kikeelectronico/pepperoni/README.md

# Pepperoni

Pepperoni es un robot de combate de 1 libra diseñado para competir en OSHWdem 2023

Documentación en: https://pepperoni.enriquegomez.me
