kikeelectronico/pepperoni/docs-web/content/galeria.md

---
title: "Galería"
---

## Primeros pasos

Primera vez que Pepperoni se desplaza sobre sus ruedas.

{{< yt "WIlDZOEus2Y" "Primeros pasos de Pepperoni" >}}

## Test de spinner

Primer test de giro del spinner de Pepperoni llegando a una velocidad del 40% de la velocidad máxima.

{{< yt "U2f0mU5--3Y" "Test de spinner de Pepperoni" >}}
