kikeelectronico/pepperoni/docs-web/docs/bloqueos/bloqueos.md

---
sidebar_position: 2
---

# Bloqueos de arma

Pepperoni cuenta con un arma cinética que de ser encendida por error puede causar daños personales y materiales. Por favor, ten mucho cuidado al manipular el robot y bloquea el arma, especialmente cuando la batería está conectada.

El robot cuenta con dos sistemas de bloqueo de arma que se alinean con uno de los agujeros del arma para atravesarla.

## Bloqueo por tornillo

Se puede introducir un tornillo M3x25 en el inserto roscado desde la parte inferior del robot.

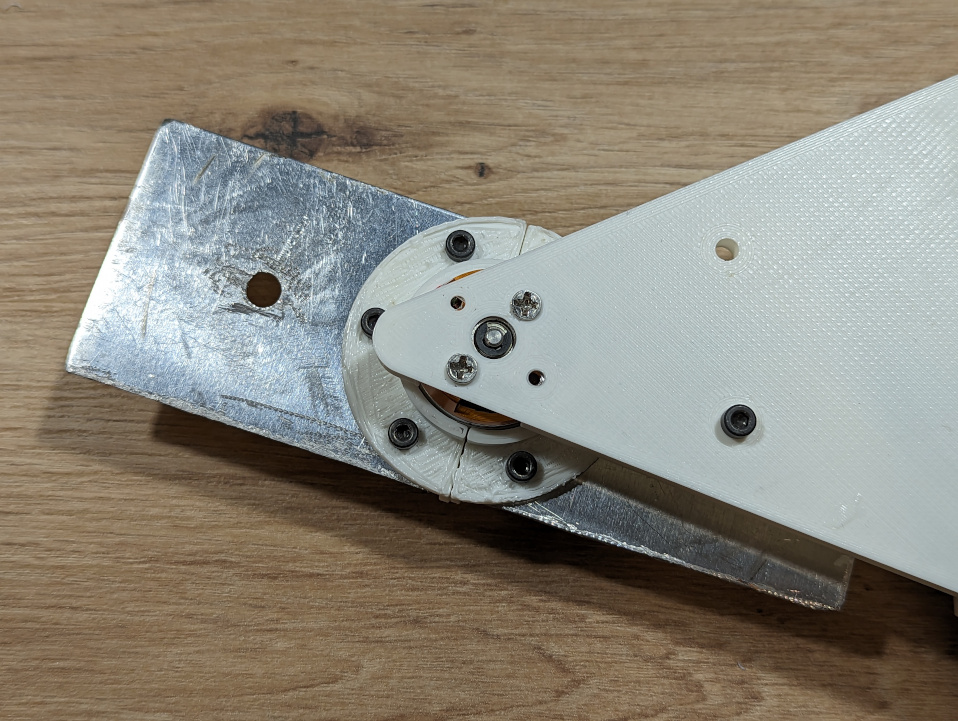
[picture p1: docs-web/docs/bloqueos/assets/tornillo_de_bloqueo.jpg]
Tornillo de bloqueo


Desde la parte superior se ve de la siguiente manera:

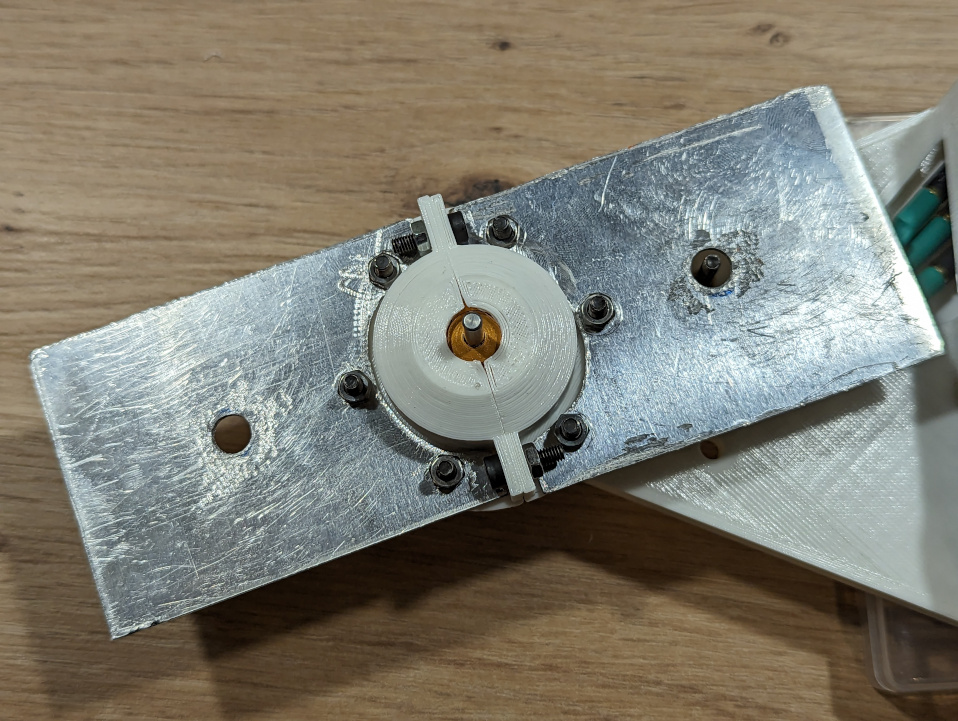
[picture p2: docs-web/docs/bloqueos/assets/arma_bloqueada_por_tornillo.jpg]
Arma bloqueada por tornillo


## Bloque por barra

Se puede introducir un objeto con forma de barra como un destornillador por el agujero de la tapa que no cuenta con inserto.

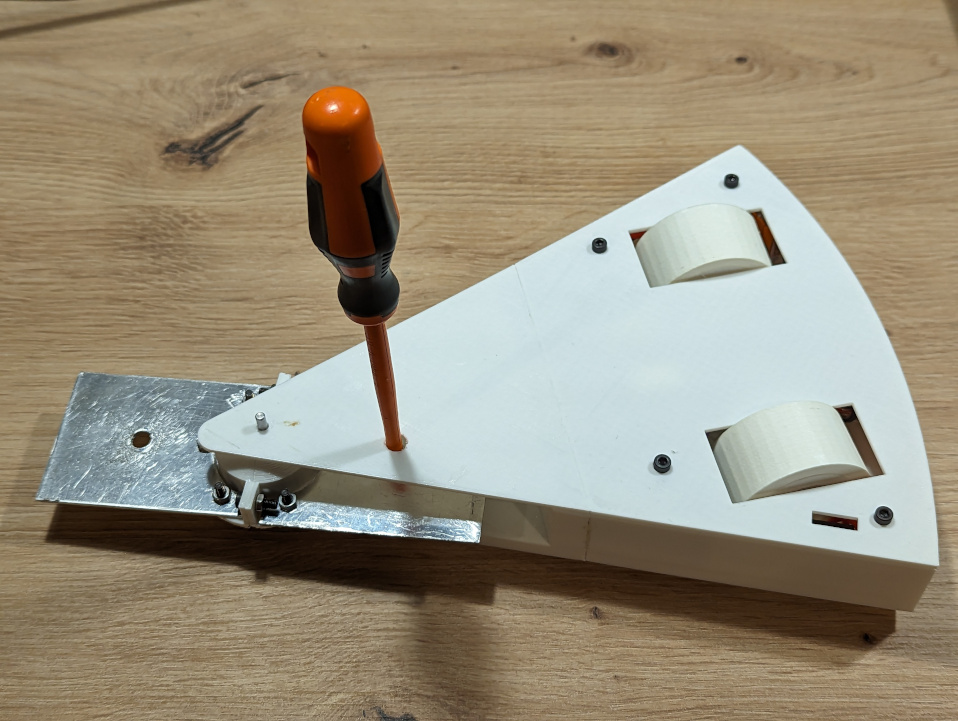
[picture p3: docs-web/docs/bloqueos/assets/arma_bloqueada_por_barra.jpg]
Arma bloqueada por una barra
