kikeelectronico/pepperoni/docs-web/content/docs/_index.md

---
title: "Documentación"
description: "Guía de construcción, configuración y uso de Pepperoni."
---

Todo lo necesario para construir, configurar y controlar a Pepperoni.
