kikeelectronico/pepperoni/docs-web/docs/bom.md

---
sidebar_position: 3
---

# BOM

| Componente | Cantidad | Enlaces de compra* |
| - | - | - |
| Motor N20 6 V 200 RPM | 2 | [Amazon](https://www.amazon.es/dp/B01N6LJN43) |
| ESC motor DC con freno | 2 | [Amazon](https://www.amazon.es/dp/B07R8PV71M) |
| Batería LiPo 2S 450 mAh | 1 | [Amazon](https://www.amazon.es/dp/B07LFJXMNP) |
| Motor brushless | 1 | [Amazon](https://www.amazon.es/dp/B01IVKZNQQ) |
| ESC motor burshless | 1 | [Amazon](https://www.amazon.es/dp/B0BGC1QQ6T) |
| Conector XT60 macho | 1 | [Amazon](https://www.amazon.es/dp/B0BM9J42HM) |
| Conector XT60 hembra | 2 | [Amazon](https://www.amazon.es/dp/B0BM9J42HM) |
| Conectores Wago | 2 | [Amazon](https://www.amazon.es/unidades-221-415-terminal-conexi%C3%B3n-transparente/dp/B07NKDCJPL) |
| Interruptor 15 A basculante | 1 | [Amazon](https://www.amazon.es/Interruptor-universal-off-Negro-Cablepelado%C2%AE/dp/B07CMG69BK) |
| Receptor RF 6 canales** | 1 | [Amazon](https://www.amazon.es/Dilwe-Receptor-Accesorio-Control-Frecuencia/dp/B07PBRSHHH/) |
| Tornillos M3x16 acero | 18 | [RationalStock](https://www.rationalstock.es/catalogo/producto/fijacion/tornillos/tornillos-cilindricos-rosca-metrica/tornillo-din-912-de-cabeza-cilindrica-con-hueco-hexagonal--de-a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) |
| Tornillos M3x25 acero | 1 | [RationalStock](https://www.rationalstock.es/catalogo/producto/fijacion/tornillos/tornillos-cilindricos-rosca-metrica/tornillo-din-912-de-cabeza-cilindrica-con-hueco-hexagonal--de-a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) |
| Insertos para plástico M3 | 10 | [Amazon](https://www.amazon.es/M2-M2-5-M3-M4-M5/dp/B0BZVL5864) |
| Tuerca M3 acero | 8 | [RationalStock](https://www.rationalstock.es/catalogo/producto/fijacion/tuercas/tuercas-hexagonales/tuerca-din-934-hexagonal--de-acero-inoxidable-a2-y-rosca-metrica-/20450500005) |
| Cableado 1 mm² | N/A | [Amazon](https://www.amazon.es/dp/B09VGQKXS1) |
| PLA | 1 kg | [Smart materials](https://www.smartmaterials3d.com/pla-filamento#/3-tamano-l_1000g/26-diametro-175_mm/103-color-snow) |
| TPU | 330 g | [Smart materials](https://www.smartmaterials3d.com/flex-filamento#/1-tamano-s_330g/8-color-ivory_white/26-diametro-175_mm) |

*Los enlaces de compra son de ejemplo. Pueden no representar con exactitud el producto.

**El receptor depende de la emisora que vayas a usar. Elige uno compatible. Yo he usado la emisora Flysky FS-i6.
