kikeelectronico/pepperoni/3d-model/3mf/stand.3mf

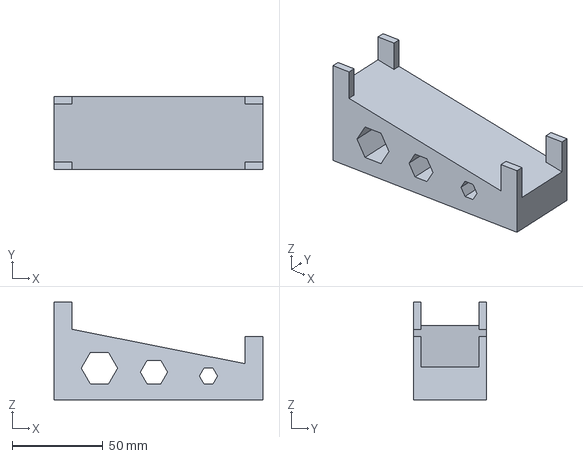
[picture p11: CAD file, 2023-11-06]
3d-model/3mf/stand.3mf
115.0 x 40.0 x 53.9 mm
