kikeelectronico/pepperoni/3d-model/3mf/plantilla pepperoni.3mf

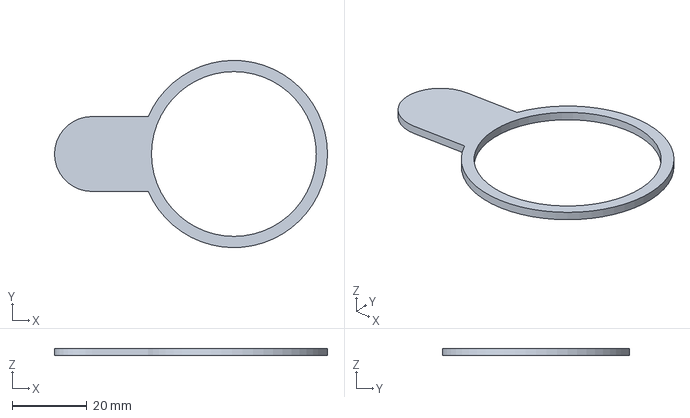
[picture p12: CAD file, 2023-10-12]
3d-model/3mf/plantilla pepperoni.3mf
72.9 x 50.0 x 2.00 mm
