kikeelectronico/pepperoni/3d-model/3mf/grapa arma.3mf

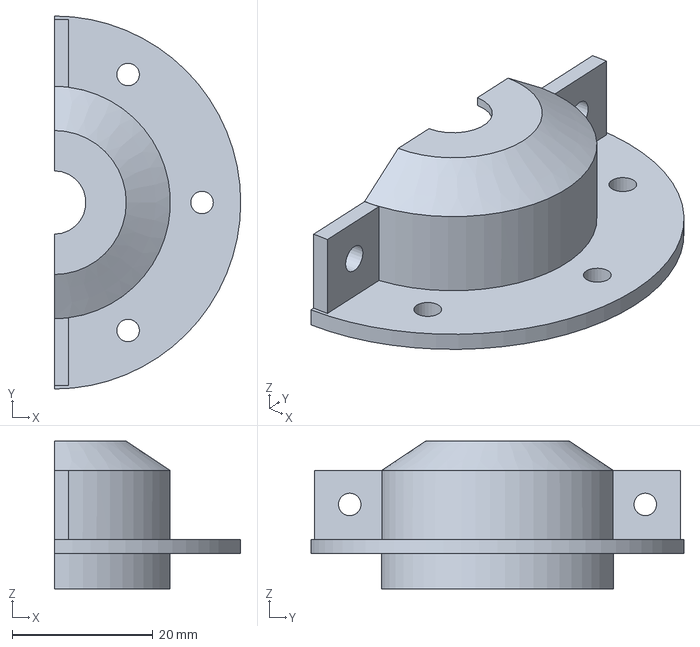
[picture p13: CAD file, 2023-10-03]
3d-model/3mf/grapa arma.3mf
26.5 x 53.0 x 21.0 mm
