kikeelectronico/pepperoni/3d-model/design/hoja arma.FCStd

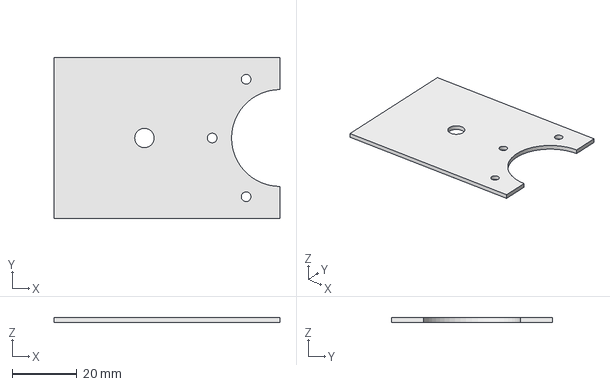
[picture p14: CAD file, 2023-10-12]
3d-model/design/hoja arma.FCStd
70.0 x 50.0 x 1.50 mm
