kikeelectronico/pepperoni/3d-model/3mf/pinza ESC.3mf

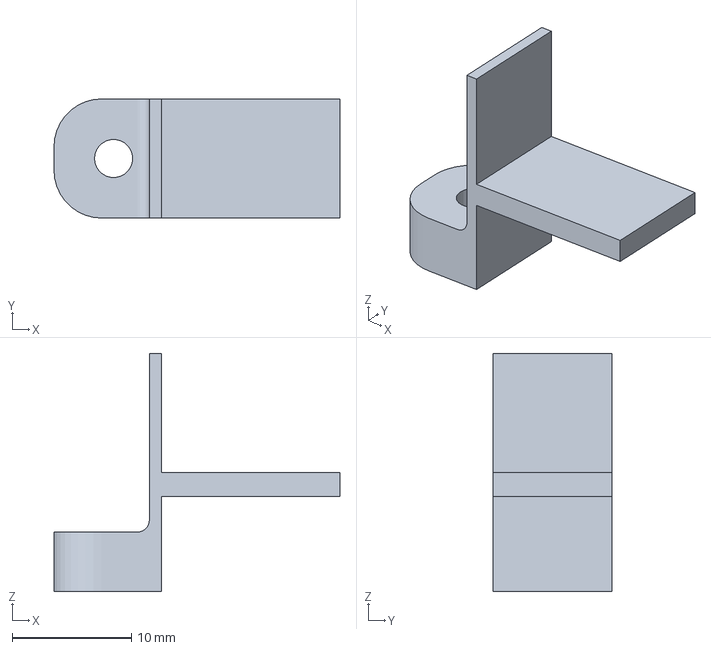
[picture p15: CAD file, 2023-10-03]
3d-model/3mf/pinza ESC.3mf
24.0 x 10.0 x 20.0 mm
