kikeelectronico/pepperoni/3d-model/design/grapa arma.FCStd

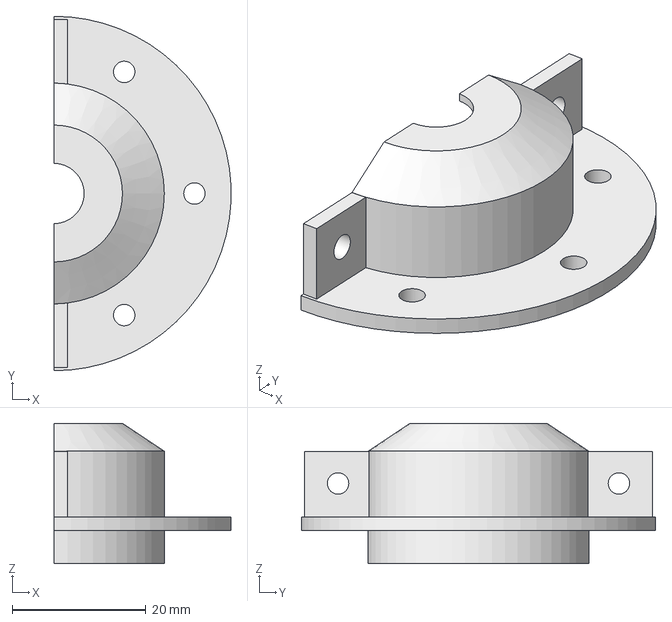
[picture p16: CAD file, 2023-10-10]
3d-model/design/grapa arma.FCStd
26.5 x 53.0 x 21.0 mm
