kikeelectronico/pepperoni/3d-model/3mf/pinza batería.3mf

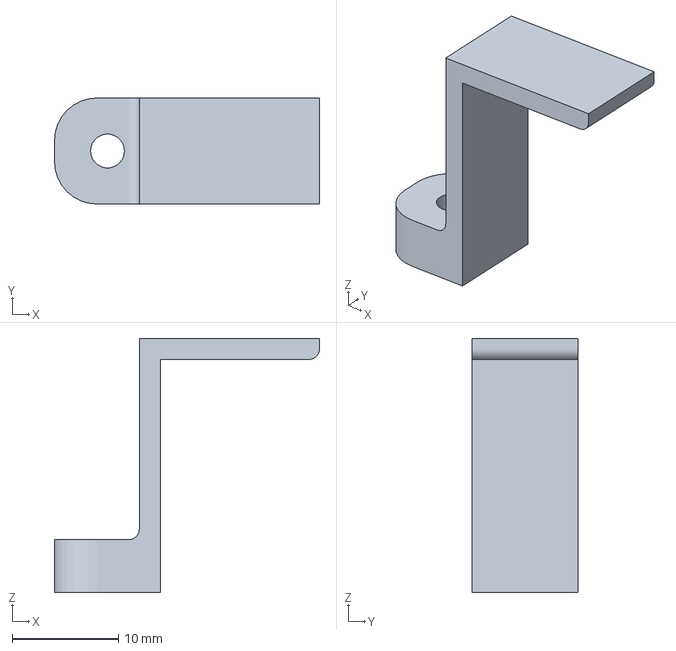
[picture p17: CAD file, 2023-10-01]
3d-model/3mf/pinza batería.3mf
25.0 x 10.0 x 24.0 mm
