kikeelectronico/pepperoni/3d-model/3mf/tapa.3mf

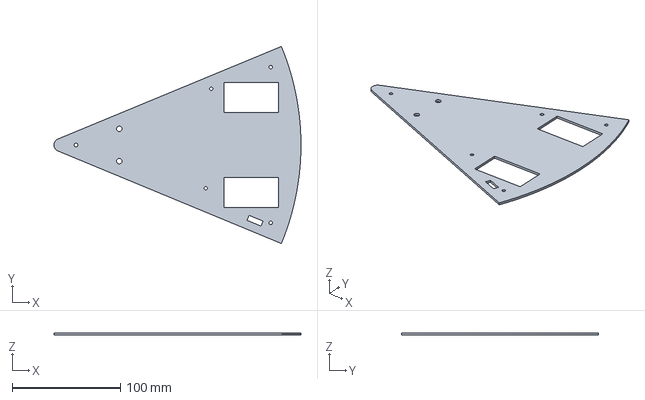
[picture p18: CAD file, 2023-10-01]
3d-model/3mf/tapa.3mf
228.3 x 182.2 x 2.00 mm
