kikeelectronico/pepperoni/3d-model/3mf/grapa motor.3mf

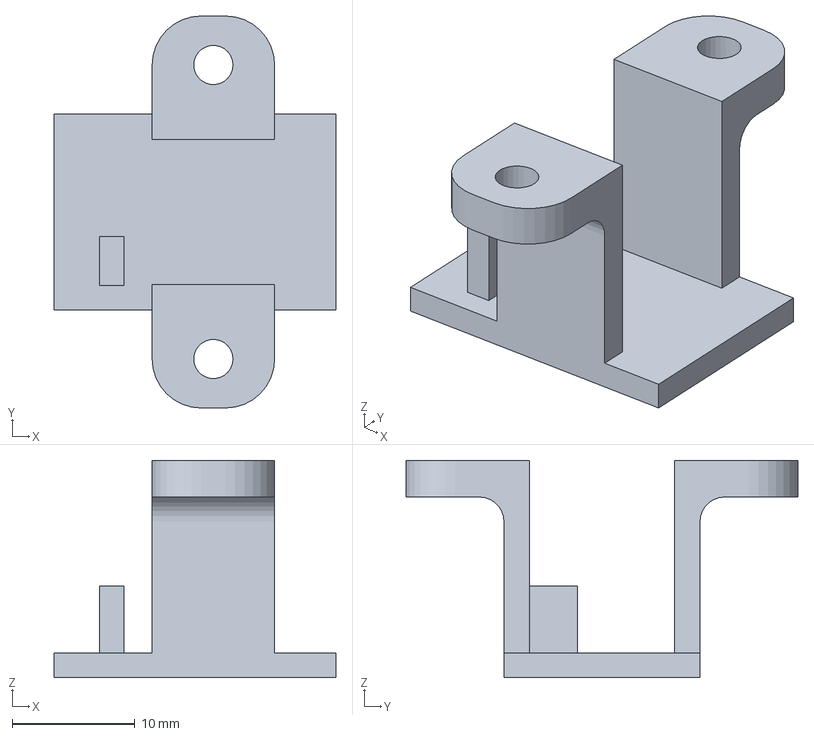
[picture p19: CAD file, 2023-09-29]
3d-model/3mf/grapa motor.3mf
23.0 x 32.0 x 17.8 mm
