kikeelectronico/pepperoni/3d-model/design/neumatico 2.FCStd

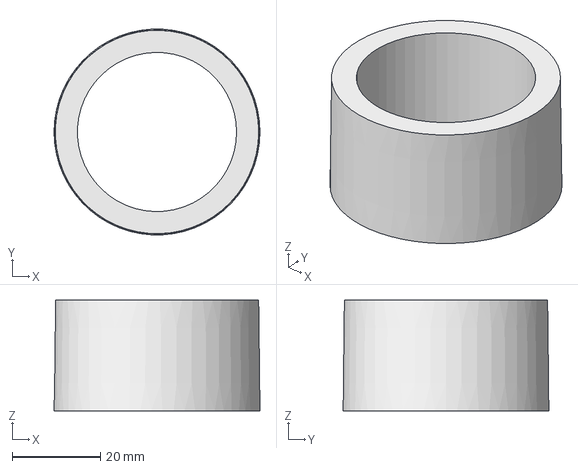
[picture p20: CAD file, 2023-09-29]
3d-model/design/neumatico 2.FCStd
46.6 x 46.5 x 25.0 mm
