kikeelectronico/pepperoni/3d-model/3mf/base.3mf

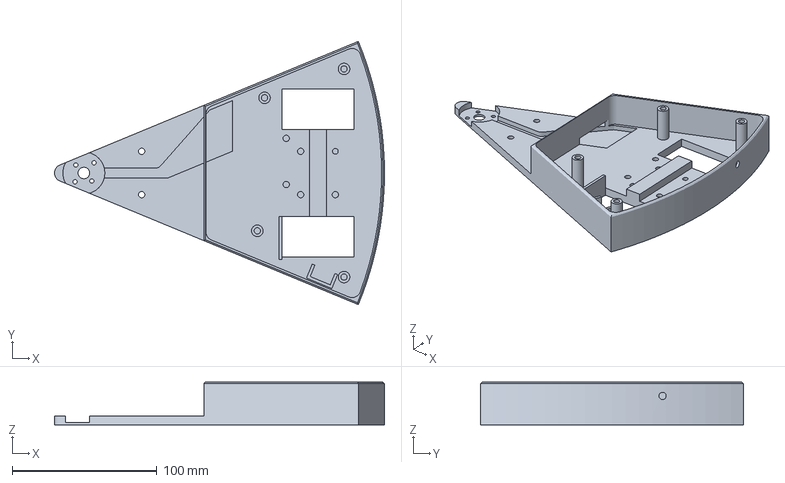
[picture p21: CAD file, 2023-09-29]
3d-model/3mf/base.3mf
228.3 x 182.2 x 29.5 mm
