kikeelectronico/pepperoni/3d-model/design/neumático.FCStd

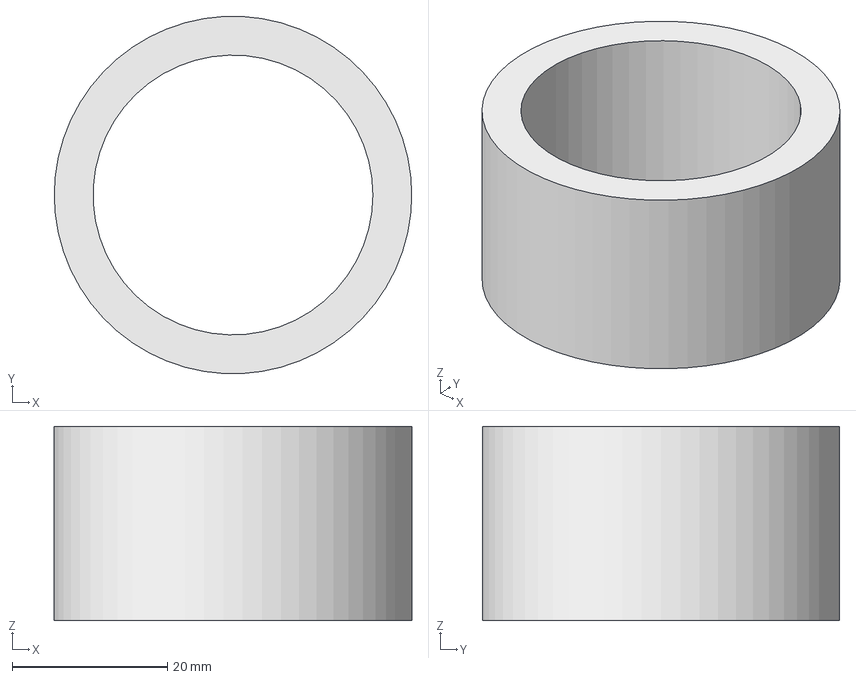
[picture p22: CAD file, 2023-09-29]
3d-model/design/neumático.FCStd
46.0 x 45.9 x 25.0 mm
