kikeelectronico/pepperoni/3d-model/3mf/llanta.3mf

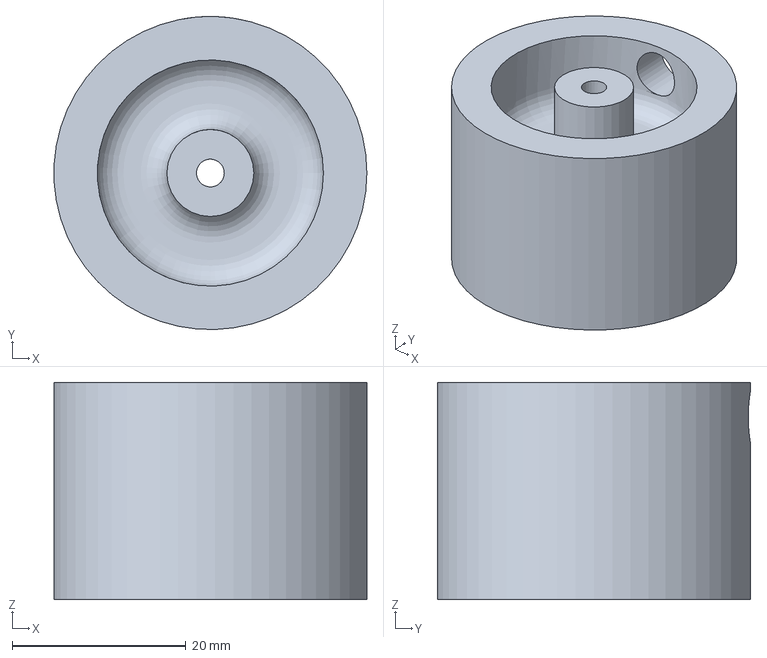
[picture p23: CAD file, 2023-09-21]
3d-model/3mf/llanta.3mf
36.0 x 36.0 x 25.0 mm
