kikeelectronico/pepperoni/3d-model/3mf/soporte ESC DC.3mf

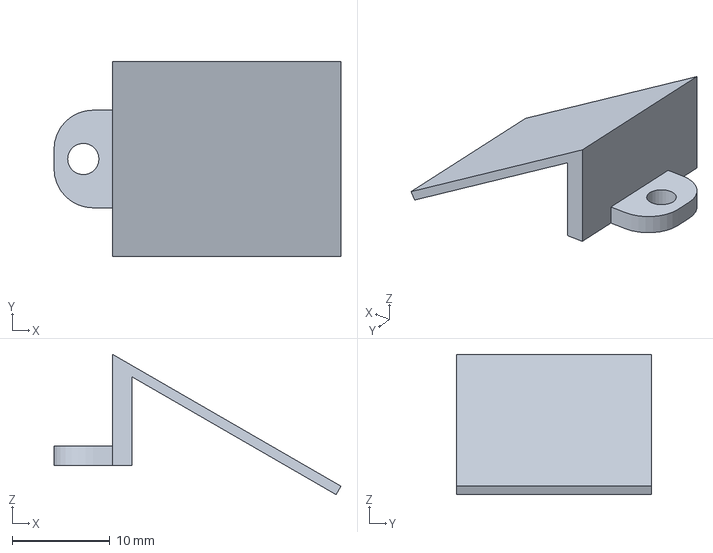
[picture p24: CAD file, 2023-09-11]
3d-model/3mf/soporte ESC DC.3mf
29.4 x 20.0 x 14.4 mm
