kikeelectronico/pepperoni/3d-model/3mf/separador 2mm.3mf

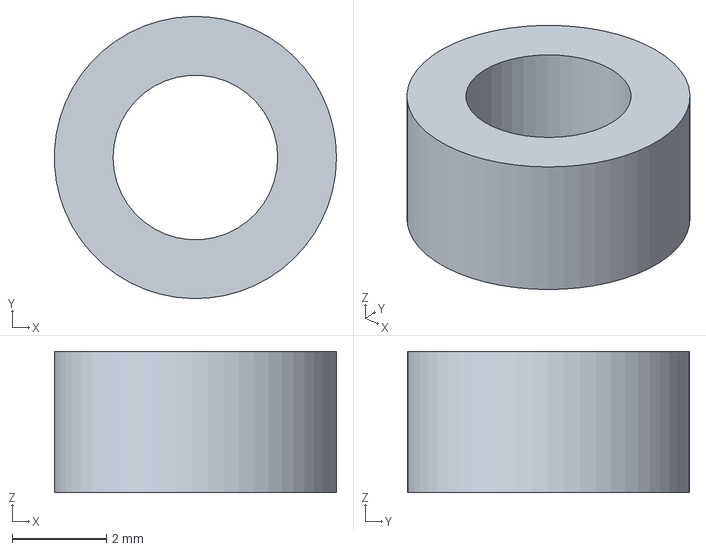
[picture p25: CAD file, 2023-09-11]
3d-model/3mf/separador 2mm.3mf
6.00 x 6.00 x 3.00 mm
