kikeelectronico/pepperoni/3d-model/design/Pepproni.FCStd

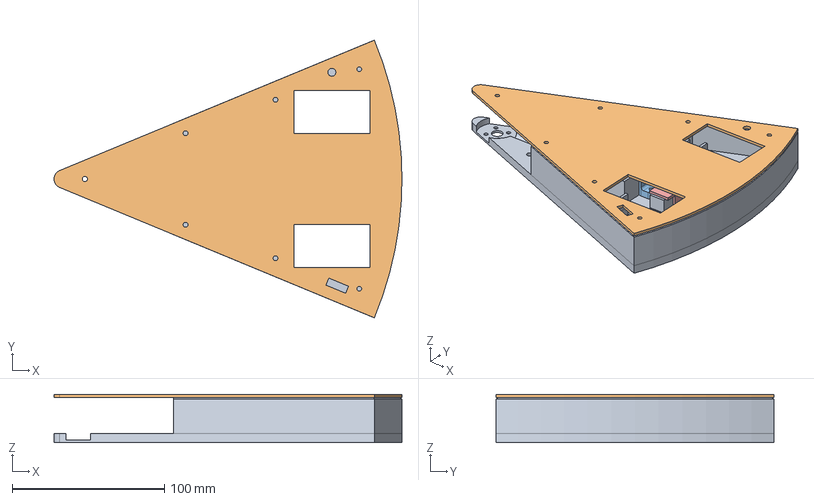
[picture p26: CAD file, 2023-09-11]
3d-model/design/Pepproni.FCStd
228.3 x 182.2 x 31.5 mm
base_001
tapa_superior_001
grapa batería_001
grapa motor_001
grapa motor_002
soporte esc dc_001
soporte esc dc_002
separador 3mm_001
separador 3mm_002
pinza ESC_001
pinza ESC_002
