kikeelectronico/pepperoni/(list of files, cad)

Other CAD files:
3d-model/design/stand.FCStd
3d-model/design/plantilla pepperoni.FCStd
3d-model/design/pinza ESC.FCStd
3d-model/design/pinza batería.FCStd
3d-model/design/grapa motor.FCStd
3d-model/3mf/neumatico 2.3mf
3d-model/3mf/neumático.3mf
3d-model/design/tapa.FCStd
3d-model/design/base.FCStd
3d-model/design/llanta.FCStd
3d-model/design/separador 2mm.FCStd
3d-model/design/soporte ESC DC.FCStd
