kikeelectronico/pepperoni/docs-web/docs/printing.md

---
sidebar_position: 4
---

# Impresión 3D

Pepperoni se conforma de múltiples piezas impresas en 3D. Todas ellas se pueden entrar en formato [3mf](https://github.com/kikeelectronico/pepperoni/tree/main/3d-model/3mf) para impresión y en el formato de diseño de [FreeCAD](https://github.com/kikeelectronico/pepperoni/tree/main/3d-model/design).

| Pieza | Material | Cantidad |
| - | - | - |
| base |  PLA | 1 |
| grapa arma |  PLA | 2 |
| grapa motor |  PLA | 2 |
| llanta |  PLA | 1 |
| neumático |  TPU | 1 |
| pinza batería |  PLA | 1 |
| pinza ESC |  PLA | 1 |
| separador 2 mm |  PLA | 2 |
| soporte ESC DC |  PLA | 2 |
| tapa |  PLA | 1 |
