kikeelectronico/pepperoni/docs-web/content/docs/ensamblaje/index.md

---
title: "Ensamblaje"
weight: 1
---

Esta guía describe el proceso de ensamblaje de Pepperoni.

## Antes de comenzar

Revisa que dispones de todos los materiales descritos en el [BOM](/docs/bom/), de todas las piezas [impresas en 3D](/docs/printing/) y de las piezas que conforman el [arma](/docs/arma/). Si usas materiales alternativos puede que necesites improvisar, pero improvisar mola.

## Paso a paso

### 1. Base del chasis

#### Materiales necesarios

- 1 x Pieza impresa _base_.
- 11 x Inserto metálico para plástico M3.

#### Proceso

Introduce los insertos en sus respectivos agujeros. Fíjate en la imagen para localizar su posición. 

Para cada inserto:

1. Coloca de forma superficial el inserto sobre el agujero.
2. Usa un soldador caliente para empujar el inserto dentro del agujero.

{{< admonition type="tip" >}}
No hagas mucha fuerza con el soldador. Los insertos se introducen muy rápidamente una vez alcanzan la temperatura óptima.
{{< /admonition >}}

Base del robot con insertos

### 2. Motor del spinner

#### Materiales necesarios

- Subensamblaje del paso anterior.
- 1 x Motor brushless.
- 4 x Tornillo M3x4.

#### Proceso

{{< tabs >}}
{{< tab label="Paso 2.1" default="true" >}}
Coloca el motor en su espacio del chasis como se muestra en la siguiente imagen. Presta atención a la alineación de los cables, estos deben guiarse por el correspondiente canal.

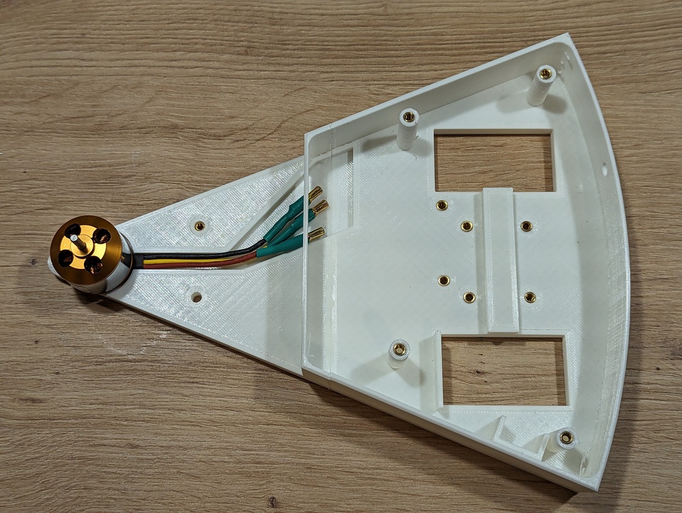
[picture p34: docs-web/docs/ensamblaje/assets/step_2_1.jpg]
Paso 2.1

{{< /tab >}}
{{< tab label="Paso 2.2" >}}
Dale la vuelta al chasis y coloca los tornillos para anclar el motor al chasis.

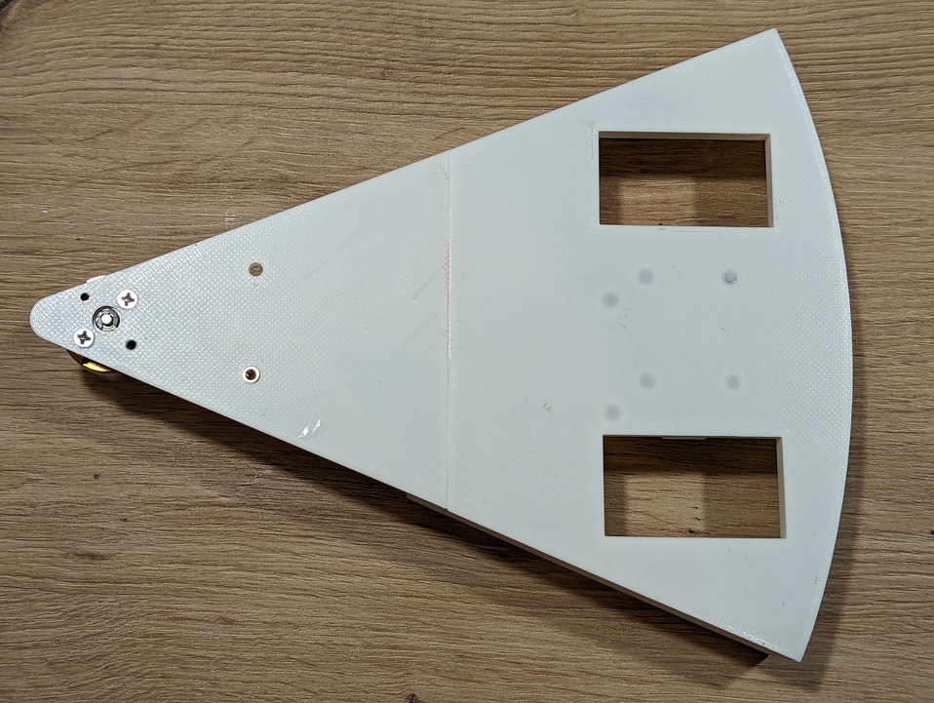
[picture p35: docs-web/docs/ensamblaje/assets/step_2_2.jpg]
Paso 2.2

{{< /tab >}}
{{< /tabs >}}

### 3. ESC del motor del spinner

#### Materiales necesarios

- Subensamblaje del paso anterior.
- 1 x Pieza impresa _pinza ESC_.
- 1 x ESC para motor brushless.
- 1 x Tornillo M3x16.

#### Proceso

{{< tabs >}}
{{< tab label="Paso 3.1" default="true" >}}
Pasa los cables del motor brushless por la apertura del chasis y conecta los tres cables del motor brushless al ESC.

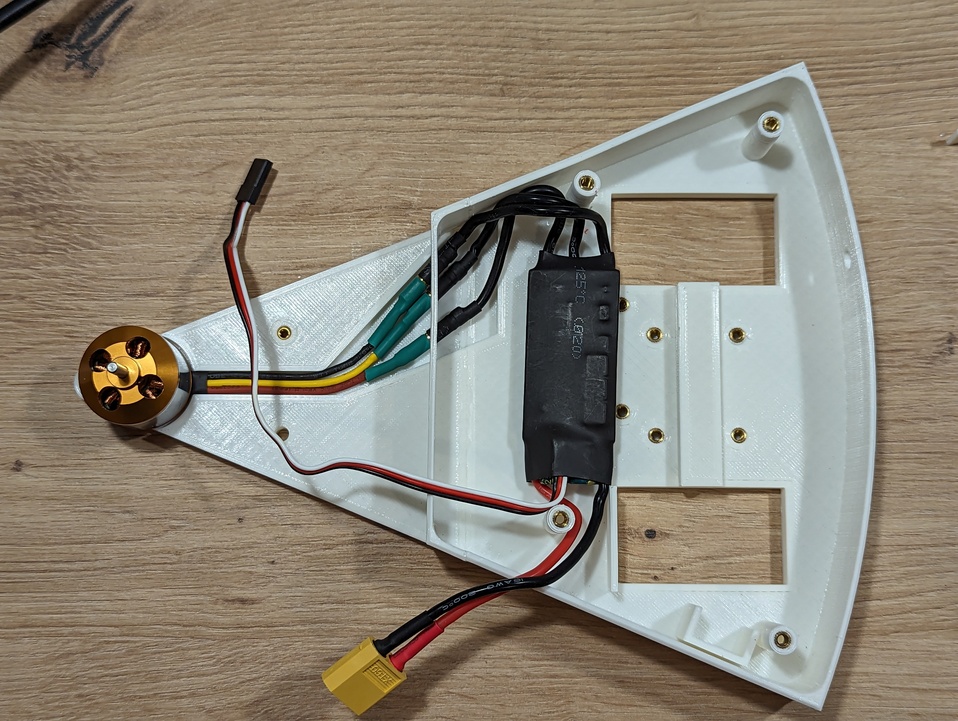
[picture p36: docs-web/docs/ensamblaje/assets/step_3_1.jpg]
Paso 3.1

{{< /tab >}}
{{< tab label="Paso 3.2" >}}
Fija el ESC al chasis usando la pieza impresa _pinza ESC_ y el tornillo M3x16.

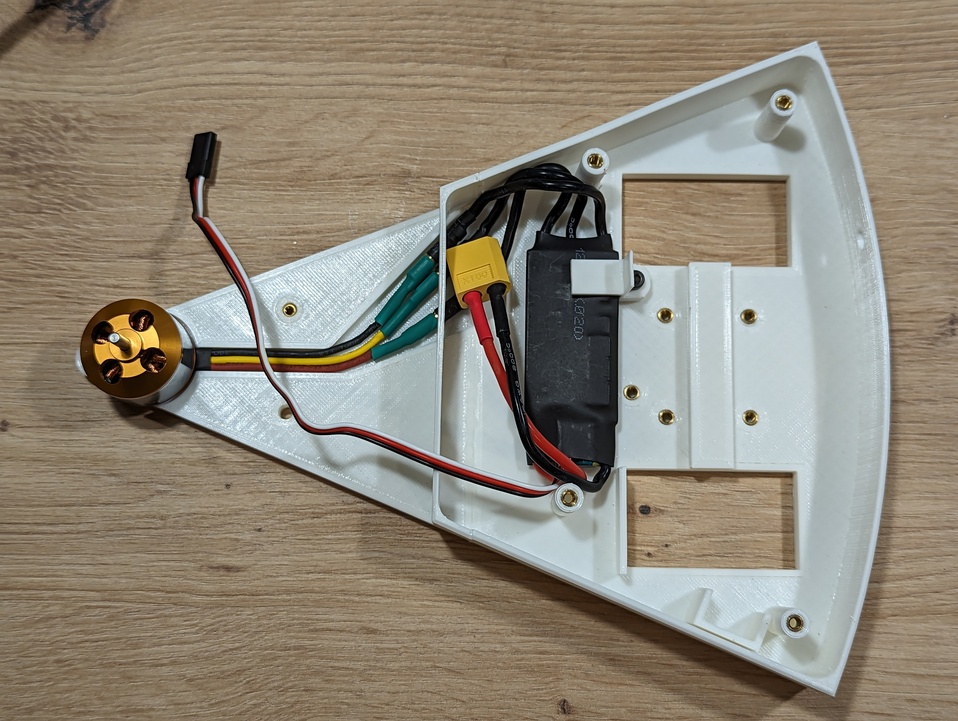
[picture p37: docs-web/docs/ensamblaje/assets/step_3_2.jpg]
Paso 3.2

{{< /tab >}}
{{< /tabs >}}

### 4. ESC y motores DC

#### Materiales necesarios

- 2 x Motor DC.
- 2 x ESC para motor DC.

#### Proceso

Para cada motor:

1. Conecta mediante cables y soldadura el motor DC con el ESC de corriente continua.
2. Quita el cable central de alimentación del conector de tres pines que irá conectado al receptor.

{{< admonition type="tip" >}}
Corta los cables con las siguientes longitudes.
- Motor DC: 50 mm.
- Conector tres pines: 60 mm.
- Cables de alimentación: 60 mm.
{{< /admonition >}}

Motor DC conectado a ESC

### 5. Ruedas

#### Materiales necesarios

- Subensamblaje del paso anterior.
- 2 x Pieza impresa _llanta_.
- 2 x Pieza impresa _neumático_.
- 2 x Inserto metálico para plástico M3.
- 2 x Tornillo M3x16.  

#### Proceso

Repite el proceso para cada rueda:

{{< tabs >}}
{{< tab label="Paso 5.1" default="true" >}}
Coloca el inserto sobre el agujero perpendicular al eje de rotación de la rueda y atornilla el tornillo girándolo muy pocas vueltas.

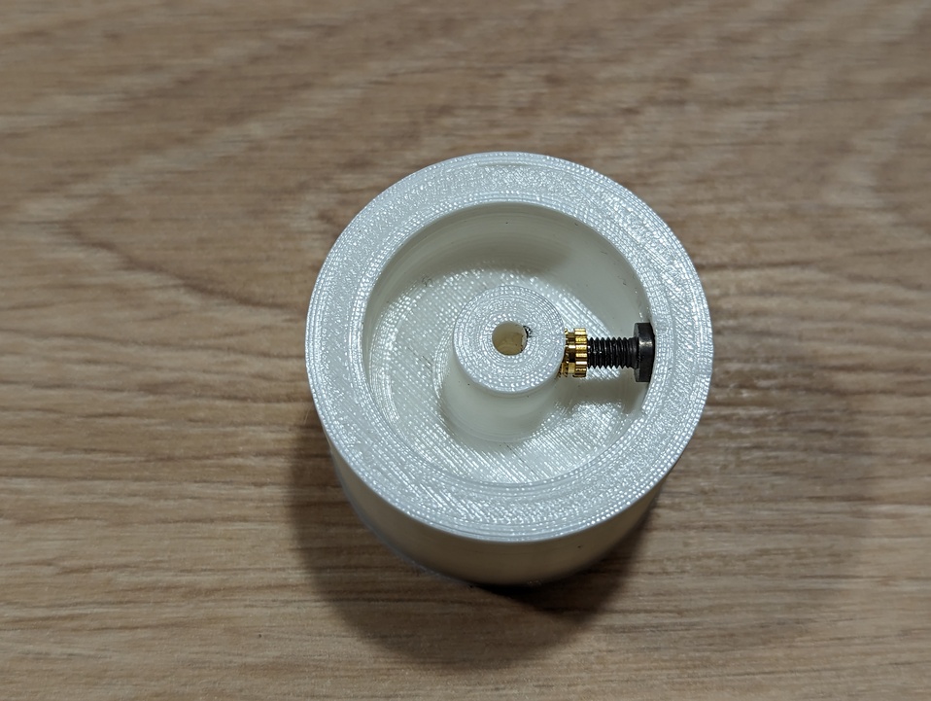
[picture p38: docs-web/content/docs/ensamblaje/assets/step_5_1.jpg]
Paso 5.1

{{< /tab >}}
{{< tab label="Paso 5.2" >}}
Introduce el eje del motor DC por el agujero central de la llanta y aprieta el tornillo hasta fijarlos. Ten en cuenta que la cara plana del eje del motor debe estar alineada con el tornillo de la llanta.

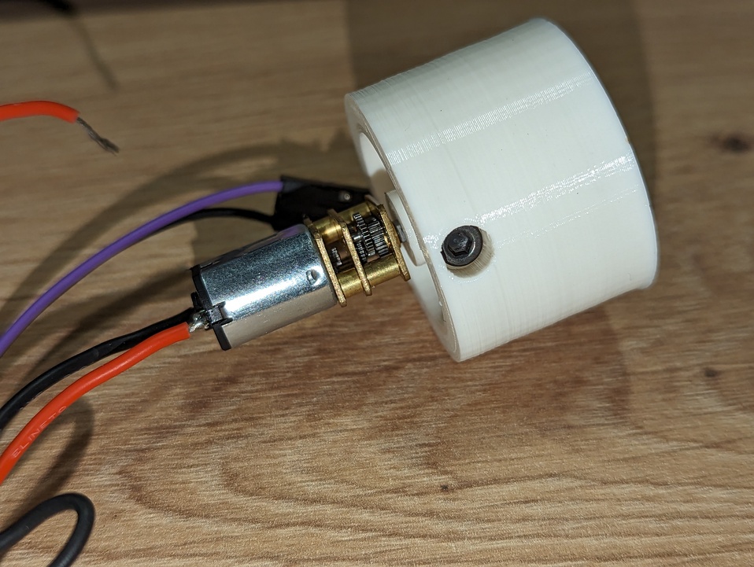
[picture p39: docs-web/content/docs/ensamblaje/assets/step_5_2.jpg]
Paso 5.2

{{< /tab >}}
{{< tab label="Paso 5.3" >}}
Coloca el neumático alrededor de la llanta.

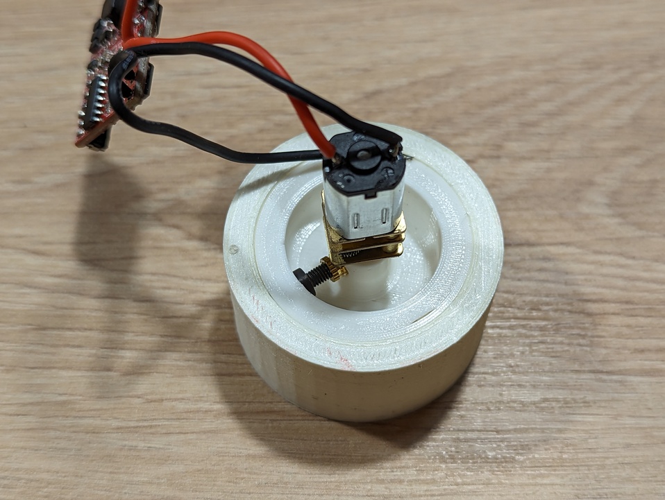
[picture p40: docs-web/docs/ensamblaje/assets/step_5_3.jpg]
Paso 5.3

{{< /tab >}}
{{< /tabs >}}

### 6. Motores en el chasis

#### Materiales necesarios

- Subensamblaje del paso 3.
- Subensamblaje del paso 5.
- 2 x Pieza impresa _grapa motor DC_.
- 2 x Pieza impresa _soporte ESC DC_.
- 2 x Pieza impresa _separador 2mm_.
- 4 x Tornillo M3x16.
- 2 x Bridas 100mm.
- 2 x Conector Wago 5 vías.

#### Proceso

Para cada motor:

{{< tabs >}}
{{< tab label="Paso 6.1" default="true" >}}
Coloca el motor en el interior de la pieza _grapa motor DC_.

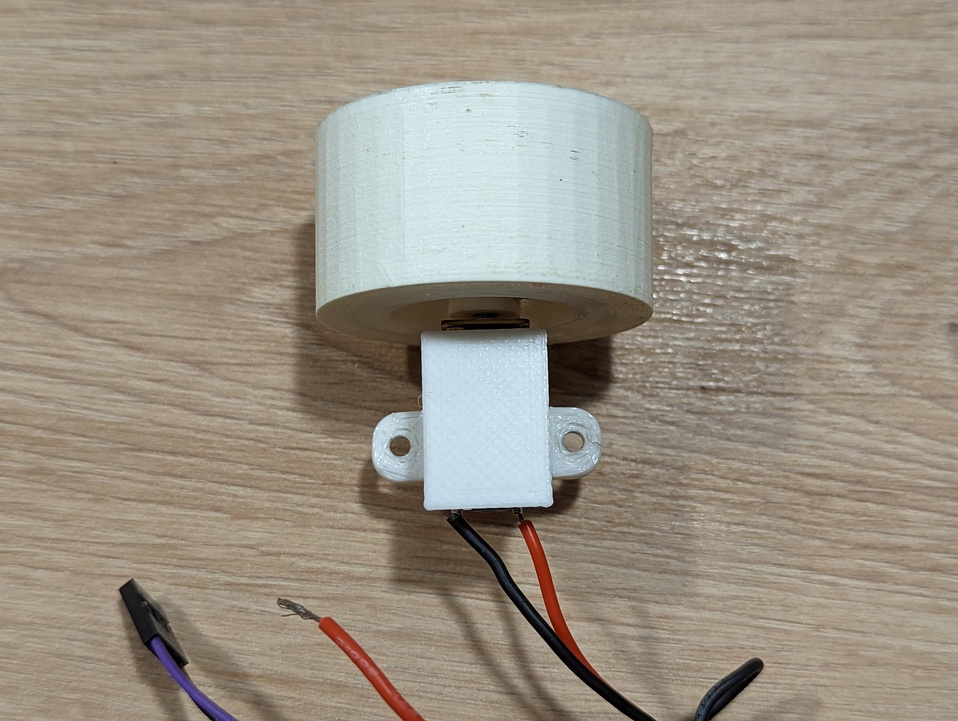
[picture p41: docs-web/docs/ensamblaje/assets/step_6_1.jpg]
Paso 6.1

{{< /tab >}}
{{< tab label="Paso 6.2" >}}
Coloca el subensamblaje del paso 6.1 en el chasis.

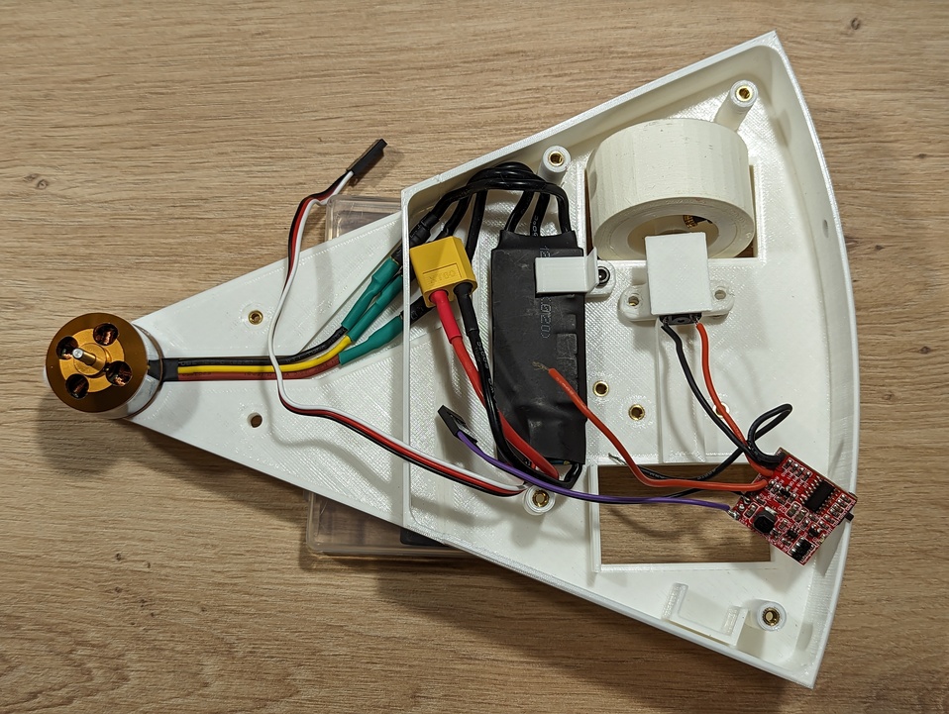
[picture p42: docs-web/docs/ensamblaje/assets/step_6_2.jpg]
Paso 6.2

{{< /tab >}}
{{< tab label="Paso 6.3" >}}
Inserta la pieza _separador 2 mm_ en un tornillo.

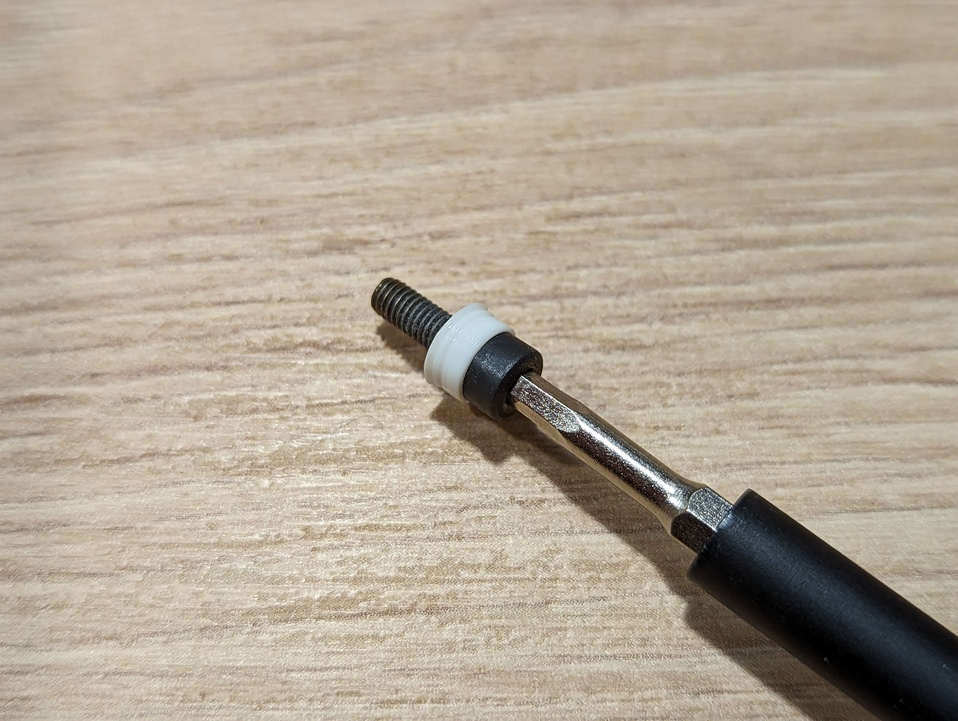
[picture p43: docs-web/docs/ensamblaje/assets/step_6_3.jpg]
Paso 6.3

{{< /tab >}}
{{< tab label="Paso 6.4" >}}
Atornilla el tornillo del paso 6.3 en el agujero más cercano a la punta del robot.

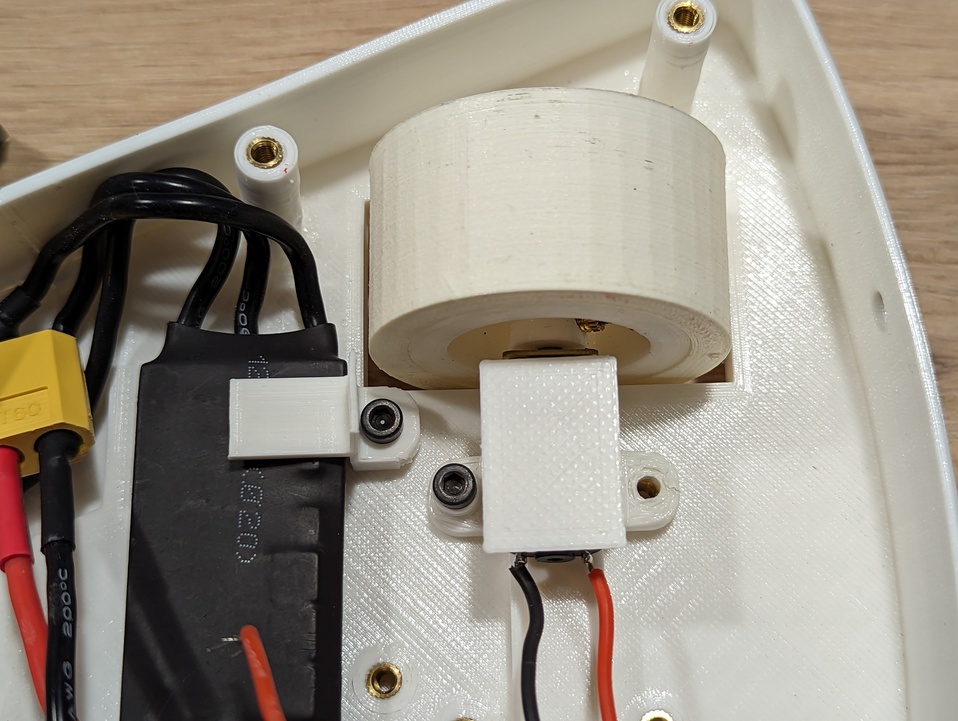
[picture p44: docs-web/content/docs/ensamblaje/assets/step_6_4.jpg]
Paso 6.4

{{< /tab >}}
{{< tab label="Paso 6.5" >}}
Coloca la pieza _soporte ESC DC_ alineando su agujero con el agujero más alejado de la punta del robot.

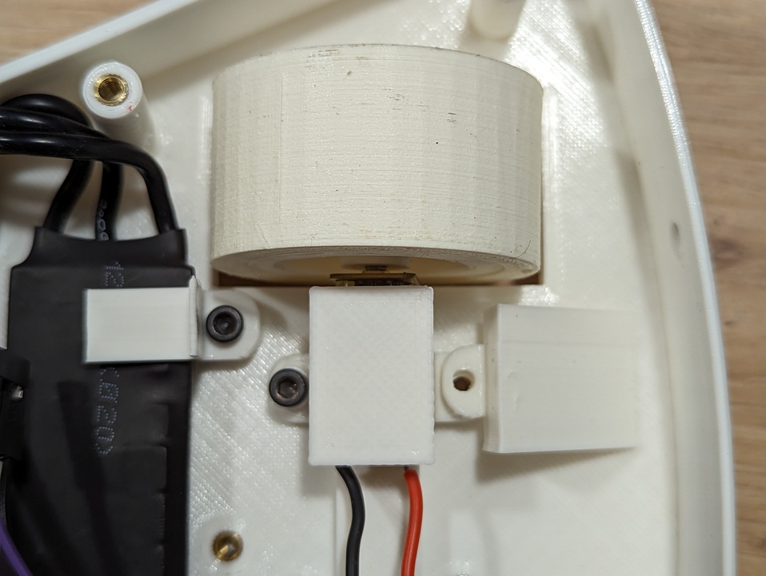
[picture p45: docs-web/docs/ensamblaje/assets/step_6_5.jpg]
Paso 6.5

{{< /tab >}}
{{< tab label="Paso 6.6" >}}
Atornilla ambas piezas al chasis.

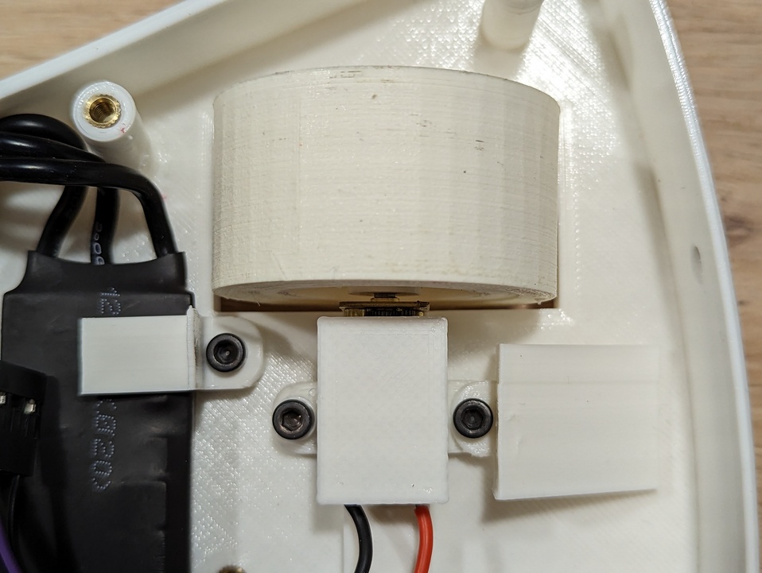
[picture p46: docs-web/docs/ensamblaje/assets/step_6_6.jpg]
Paso 6.6

{{< /tab >}}
{{< tab label="Paso 6.7" >}}
Fija el ESC a la pieza _soporte ESC DC_ usando una brida y corta el exceso de esta.

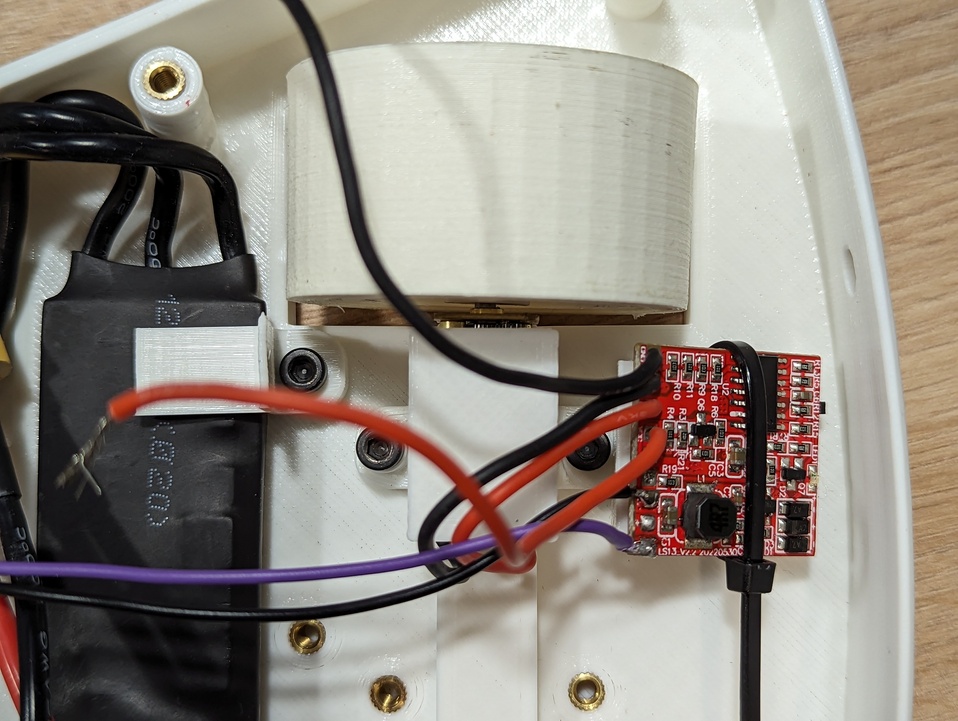
[picture p47: docs-web/docs/ensamblaje/assets/step_6_7.jpg]
Paso 6.7

{{< /tab >}}
{{< /tabs >}}

{{< admonition type="caution" title="Atención" >}}
Observa que la pieza impresa _grapa motor DC_ cuenta con una protuberancia que encaja en la reductora del motor.

Motor DC junto a la pieza impresa grapa motor DC
{{< /admonition >}}

El resultado tras colocar ambos motores debe ser el siguiente:

Ambos motores y ambos ESC montados en el robot

Completa el montaje de los motores en el chasis colocando los dos conectores Wago, uno a cada lado del robot. Observa como el conector de masa se encuentra en el lado derecho del robot (parte superior de la foto).

Robot con los conectores Wago colocados

### 7. Arnés de cableado

#### Materiales necesarios

- Subensamblaje del paso anterior.
- 1 x Conector XT60 macho.
- 1 x Conector XT60 hembra.
- 1 x Interruptor.
- Cable 1 mm² rojo y negro.

#### Proceso

{{< tabs >}}
{{< tab label="Paso 7.1" default="true" >}}
Prepara un cable como el de la foto usando el conector XT60 hembra, 32 cm de cable rojo y 18 cm de cable negro.

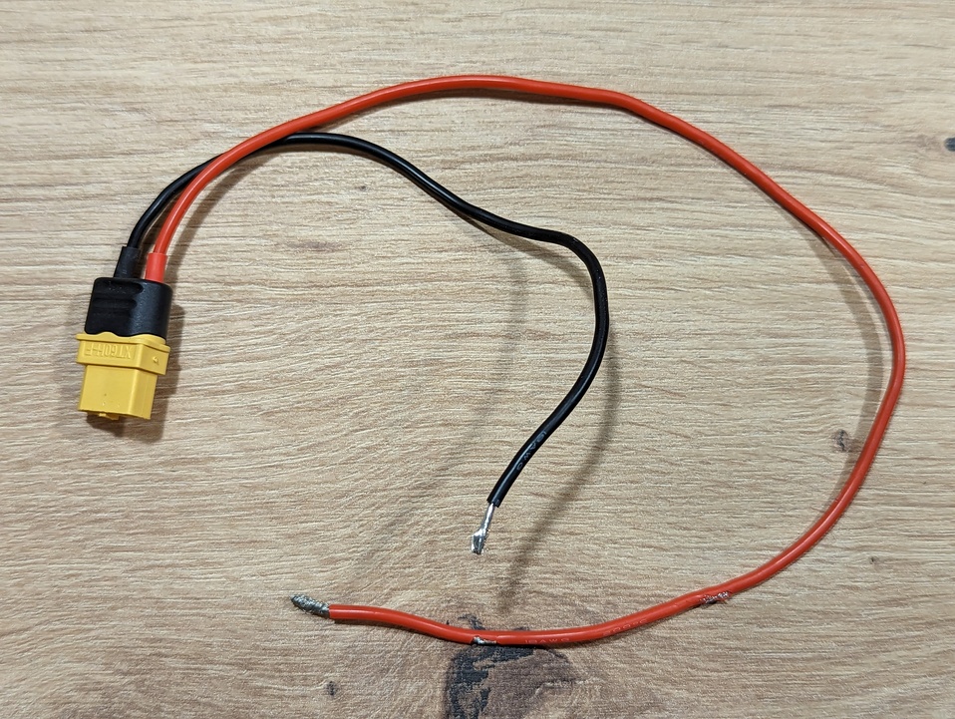
[picture p48: docs-web/content/docs/ensamblaje/assets/step_7_1.jpg]
Paso 7.1

{{< /tab >}}
{{< tab label="Paso 7.2" >}}
Conecta el conector XT60 del cable del paso 7.1 al ESC del motor brushless y los otros extremos a los correspondiente conectores Wago.

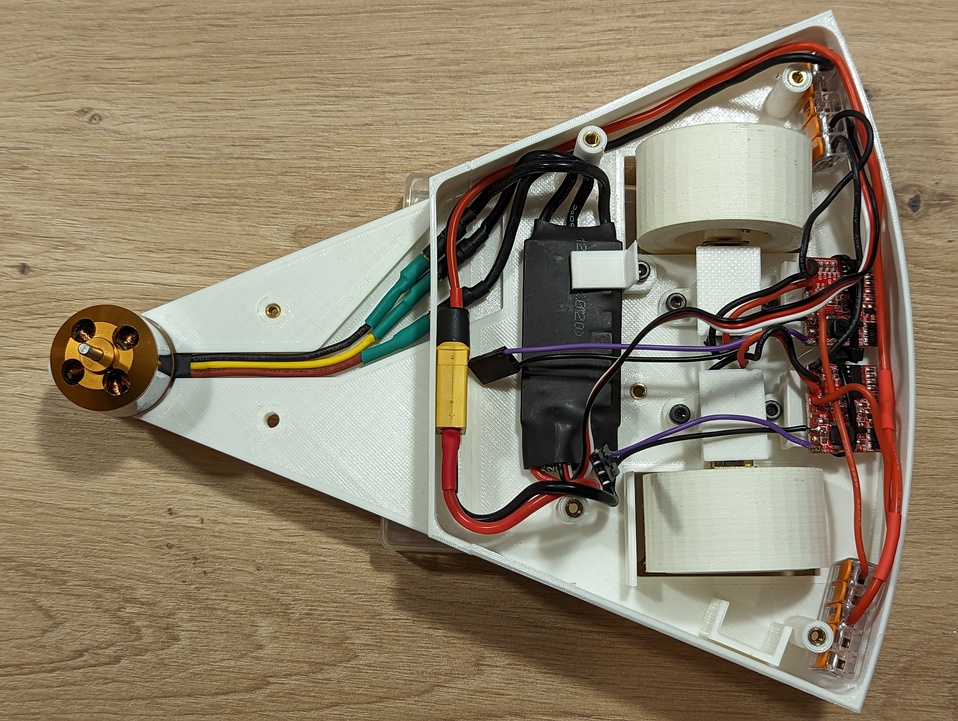
[picture p49: docs-web/docs/ensamblaje/assets/step_7_2.jpg]
Paso 7.2

{{< /tab >}}
{{< tab label="Paso 7.3" >}}
Prepara un cable como el de la foto usando el conector XT60 macho, el interruptor, 42 cm de cable rojo, 6 cm de cable rojo y 25 cm de cable negro.

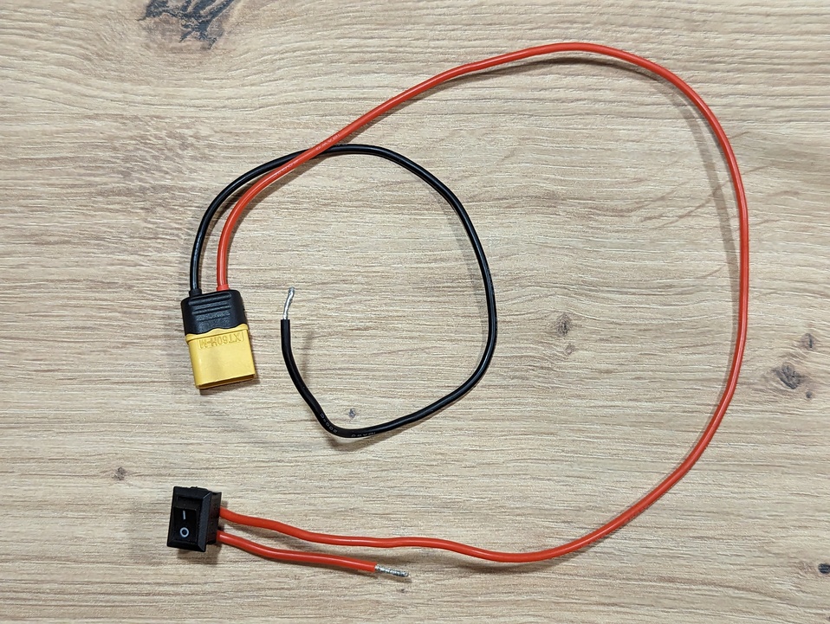
[picture p50: docs-web/docs/ensamblaje/assets/step_7_3.jpg]
Paso 7.3

{{< /tab >}}
{{< tab label="Paso 7.4" >}}
Coloca el cable del paso 7.3 como se muestra en la foto. Inserta el interruptor en su hueco, conecta los extremos libres a los conectores Wago correspondientes y deja libre el conector XT60 para la batería.

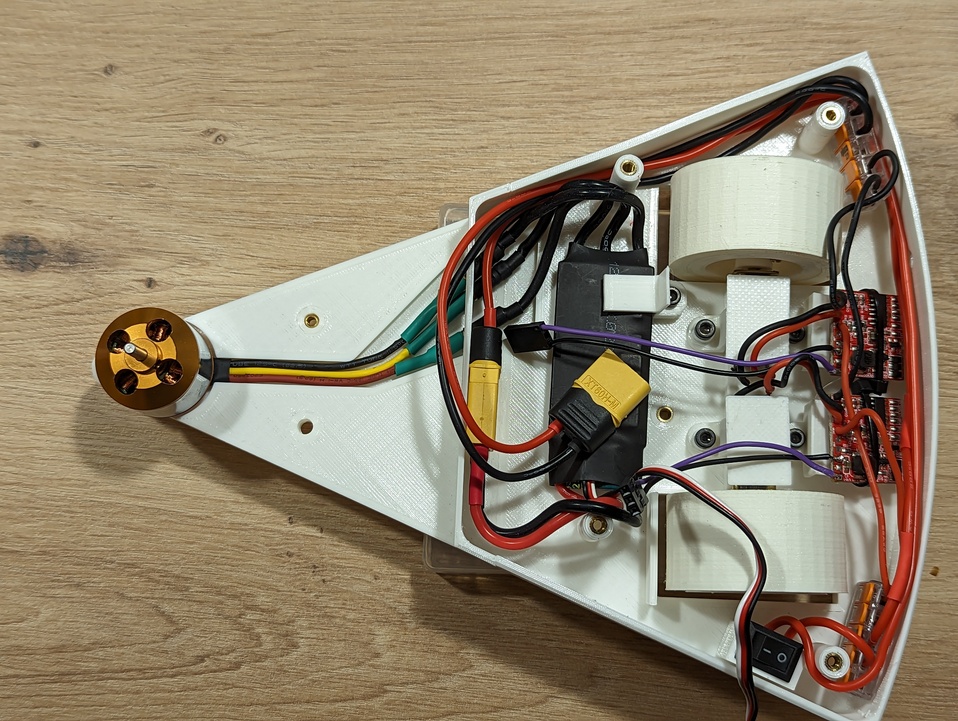
[picture p51: docs-web/docs/ensamblaje/assets/step_7_4.jpg]
Paso 7.4

{{< /tab >}}
{{< /tabs >}}

{{< admonition type="note" title="Un dato curioso" >}}
Si te fijas, el cable del paso 7.1 está dañado. Esto de debe a que estas fotos se hicieron tras el combate de la [OSHWDem](https://oshwdem.org/) 2023. Revisando los vídeos de los combates, creo que estos daños los causó [Abrelatas](https://github.com/JavierIH/abrelatas) en el combate _todos contra todos_.
{{< /admonition >}}

### 8. Receptor

#### Materiales necesarios

- Subensamblaje del paso anterior.
- 1 x Receptor RF. 

#### Proceso

{{< admonition type="caution" title="Atención" >}}
Presta especial atención a la orientación de los conectores.
{{< /admonition >}}

1. Conecta el ESC del motor DC derecho en el canal 1 del receptor.
2. Conecta el ESC del motor DC izquierdo en el canal 2 del receptor.
3. Conecta el ESC del motor brushless en el canal 3 del receptor.
4. Coloca el receptor RF en la parte izquierda del robot tal y como se observa en la imagen.

Robot con el receptor RF colocado

### 9. Arma

#### Materiales necesarios

- Subensamblaje del paso anterior.
- 2 x Pieza impresa _grapa arma_.
- 2 x Hojas del arma.
- 8 x Tornillos M3x16.
- 8 x Tuerca M3. 
- Cinta de doble cara acolchada.

#### Proceso

{{< tabs >}}
{{< tab label="Paso 9.1" default="true" >}}
Coloca un fragmento de cinta de doble cara en el interior de cada pieza _grapa arma_

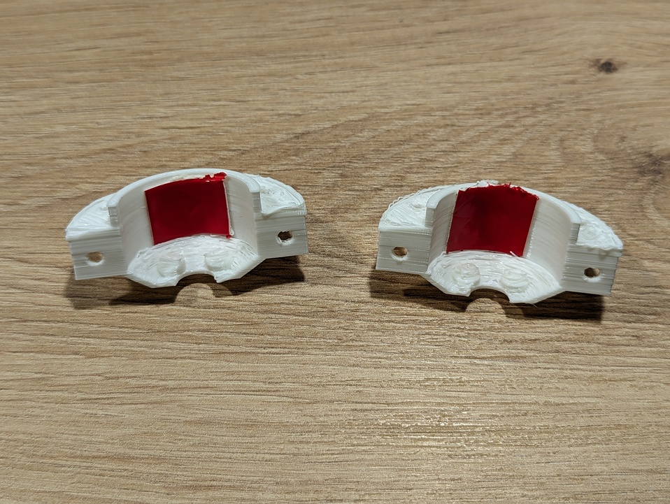
[picture p52: docs-web/docs/ensamblaje/assets/step_9_1.jpg]
Paso 9.1

{{< /tab >}}
{{< tab label="Paso 9.2" >}}
Encaja las piezas del paso 9.1 en el motor brushless. Ten en cuenta que los pines de alineación de las piezas impresas encajan en los agujeros superiores del motor.

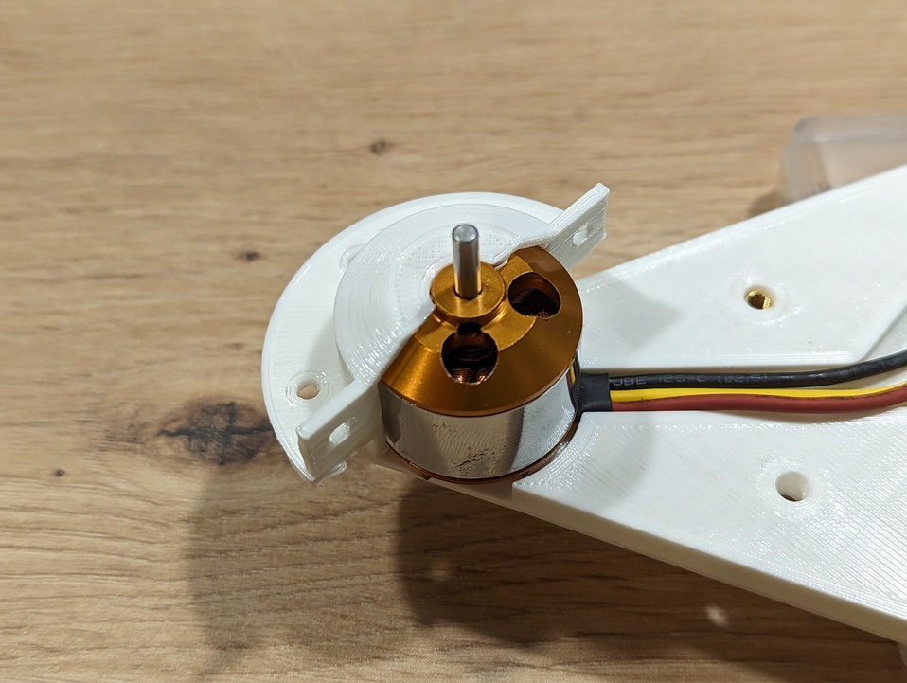
[picture p53: docs-web/content/docs/ensamblaje/assets/step_9_2.jpg]
Paso 9.2

{{< /tab >}}
{{< tab label="Paso 9.3" >}}
Fija ambas piezas con dos tornillos y dos tuercas.

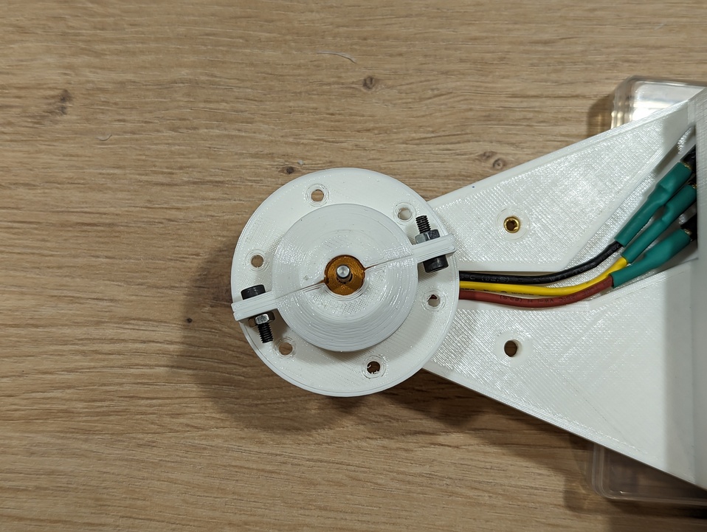
[picture p54: docs-web/docs/ensamblaje/assets/step_9_3.jpg]
Paso 9.3

{{< /tab >}}
{{< tab label="Paso 9.4" >}}
Une las hojas del arma a las grapas del arma con tornillos y tuercas. Observa como los tornillos se introducen desde la parte inferior del arma.

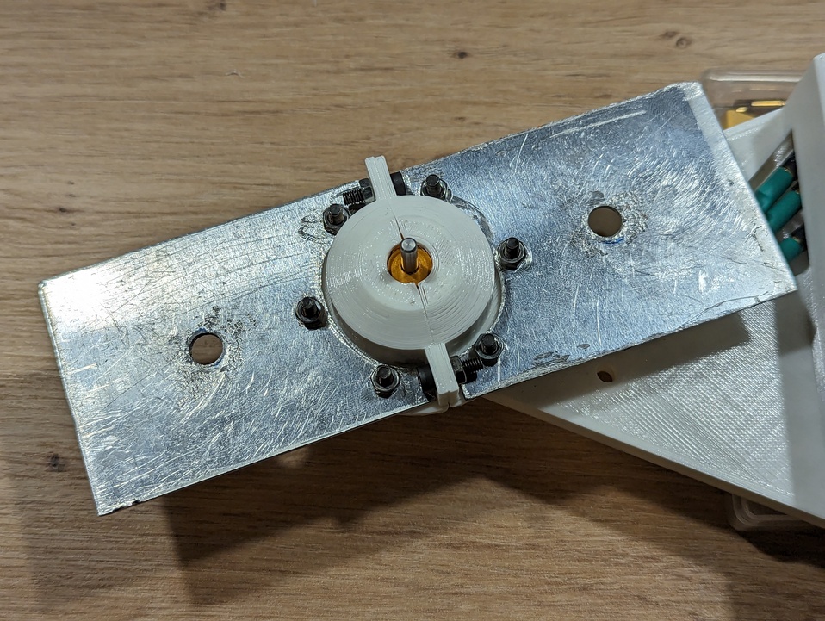
[picture p55: docs-web/docs/ensamblaje/assets/step_9_4.jpg]
Paso 9.4

{{< /tab >}}
{{< /tabs >}}

### 10. Batería

#### Materiales necesarios

- Subensamblaje del paso anterior.
- 1 x Pieza impresa _pinza batería_.
- 1 x Batería.
- 1 x Tornillo M3x16.

#### Proceso

{{< admonition type="danger" title="Peligro" >}}
Asegurate de tener bloqueada el arma de forma mecánica antes de conectar la batería. Revisa el documento [Bloqueo de arma](/docs/bloqueos/).
{{< /admonition >}}
{{< admonition type="caution" title="Atención" >}}
Coloca la batería solo cuando vayas a usar el robot.
{{< /admonition >}}

1. Conecta la batería al conector XT60 de alimentación.
2. Coloca la batería como se observa en la imagen inferior.
3. Coloca la pieza _pinza batería_ y fíjala con el tornillo.

Bateria colocada en el robot

### 11. Tapa

#### Materiales necesarios

- Subensamblaje del paso anterior.
- 1 x Pieza impresa _tapa_.
- 4 x Tornillo M3x16.

#### Proceso

1. Coloca y alinea la pieza _tapa_.
2. Coloca los cuatro tornillos para fijar la tapa.

Robot cerrado con la tapa superior
