kikeelectronico/pepperoni/docs-web/content/docs/ensamblaje/assets/step_7b.jpg

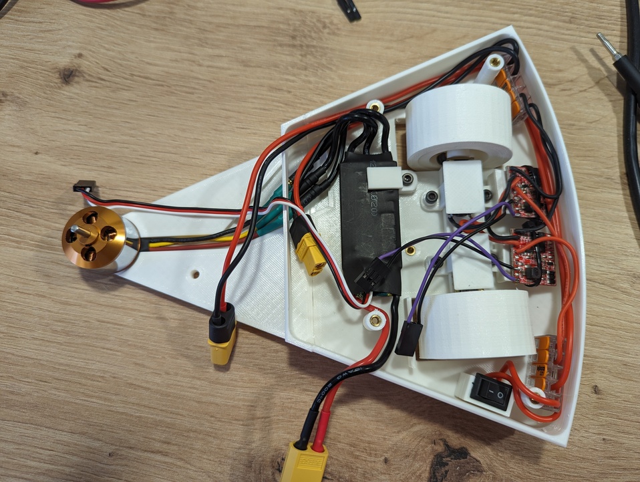
docs-web/content/docs/ensamblaje/assets/step_7b.jpg
