kikeelectronico/pepperoni/docs-web/docs/ensamblaje/assets/step_3.jpg

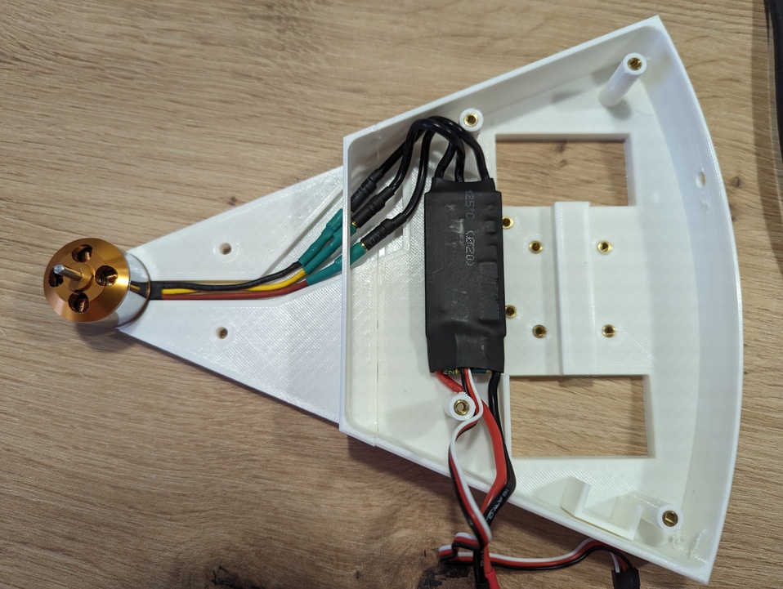
docs-web/docs/ensamblaje/assets/step_3.jpg
