kikeelectronico/pepperoni/docs-web/docs/ensamblaje/assets/step_6b.jpg

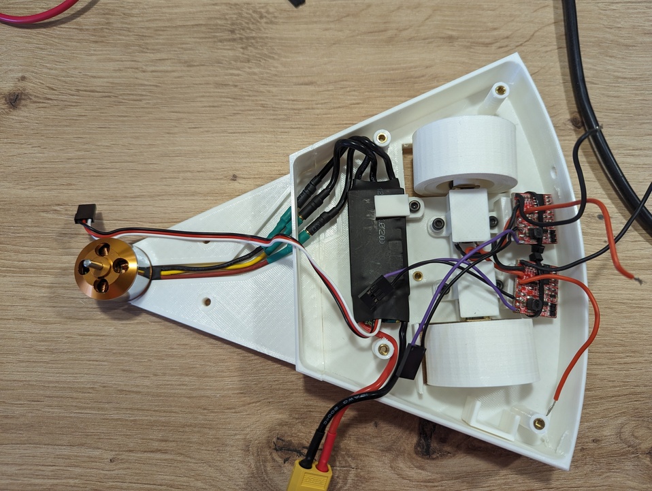
docs-web/docs/ensamblaje/assets/step_6b.jpg
