kikeelectronico/pepperoni/3d-model/Hoja del arma.pdf

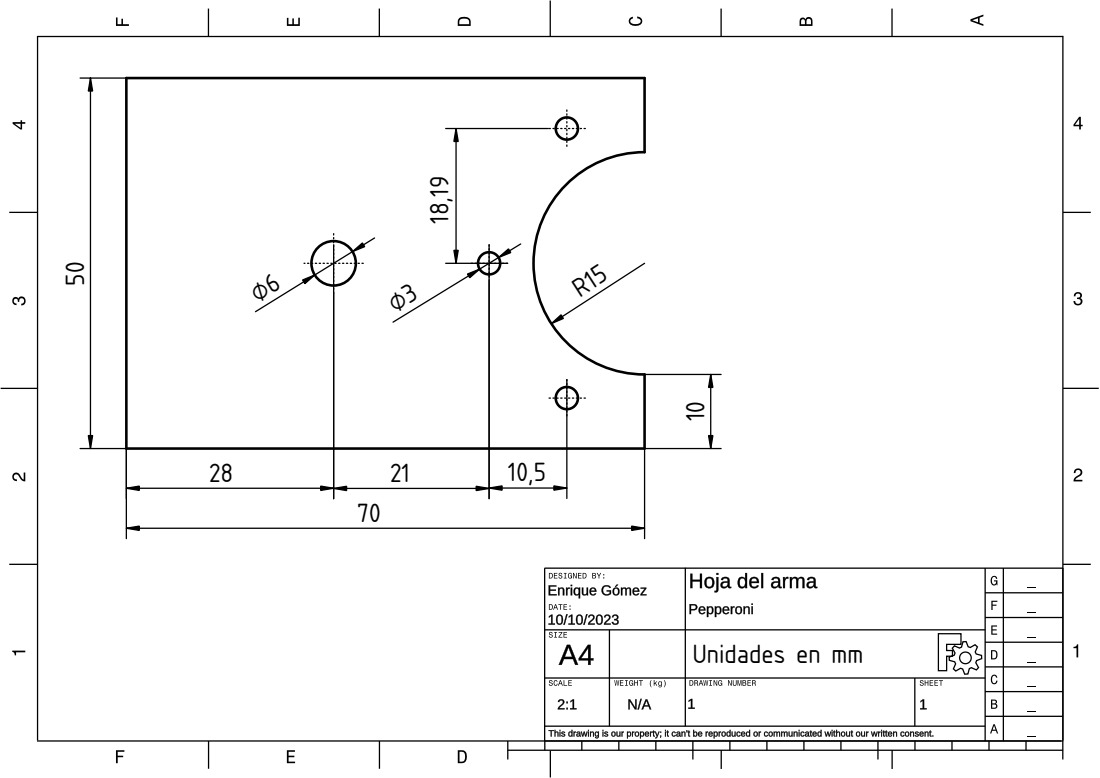
[picture p59: page 1]

Unidades en mm
