kikeelectronico/pepperoni/(commit log)

2023-09-06 hello base 3d model
    [base.FCStd]
2023-09-08 base design
    [base.FCStd]
2023-09-09 tapa superior y cambios en base
    [base.FCStd, tapa_superior.FCStd]
2023-09-09 base y tapa
    [base.FCStd, tapa_superior.FCStd]
2023-09-09 new layout
    [base.FCStd]
2023-09-09 base and tapa update
    [Pepproni.FCStd, base.FCStd, tapa_superior.FCStd]
2023-09-09 updata tapa
    [Pepproni.FCStd, tapa_superior.FCStd]
2023-09-10 add indicator LED hole
    [Pepproni.FCStd, tapa_superior.FCStd]
2023-09-10 add grapa batería
    [Grapa batería.3mf, Grapa batería.FCStd, Pepproni.FCStd, base.FCStd]
2023-09-10 update grapa batería
    [Pepproni.FCStd, grapa batería.3mf, grapa batería.FCStd]
2023-09-10 weight optimization
    [Pepproni.FCStd, base.3mf, base.FCStd, grapa batería.FCStd, tapa superior.3mf, tapa_superior.FCStd]
2023-09-11 adjust weight and add parts
    [Pepproni.FCStd, base.3mf, base.FCStd, grapa motor.3mf, grapa motor.FCStd, pinza ESC.FCStd, pinza esc.3mf, separador 3mm.3mf]
2023-09-24 edit some things
    [neumático.3mf, neumático.FCStd, tapa superior.3mf, tapa.3mf, tapa.FCStd, tapa_superior.FCStd]
2023-09-29 nuevos cambios en el chasis
    [base.3mf, base.FCStd, grapa motor.3mf, grapa motor.FCStd, neumatico 2.3mf, neumatico 2.FCStd, neumático.FCStd, tapa.3mf]
2023-10-01 eliminar grapa batería
    [grapa batería.FCStd]
2023-10-01 pinza batería
    [pinza batería.3mf, pinza batería.FCStd]
2023-10-03 add weapon grip and modify esc grip
    [grapa arma.3mf, grapa arma.FCStd, pinza ESC.3mf, pinza ESC.FCStd, pinza esc.3mf]
2023-10-05 add bom
2023-10-05 printing guide
2023-10-09 update assembly guide
2023-10-09 update bom
2023-10-09 update links and assembly docs
2023-10-10 add weapon sheet design
    [grapa arma.FCStd, hoja arma.FCStd]
2023-10-10 rename files
    [separador 2mm.3mf, separador 2mm.FCStd, soporte ESC DC.3mf, soporte ESC DC.FCStd]
2023-10-10 info sobre la emisora
2023-10-12 recover file
    [hoja arma.FCStd]
2023-10-12 pepperoni paint template
    [plantilla pepperoni.3mf, plantilla pepperoni.FCStd]
2023-11-06 add a stand for display the bot
    [stand.3mf, stand.FCStd]
